borisnimcevic/flicker_stitch/fs_led_res_0805/fs_led_res_0805.kicad_pcb

## KiCad design fs_led_res_0805/fs_led_res_0805.kicad_pcb (2026-09-19)

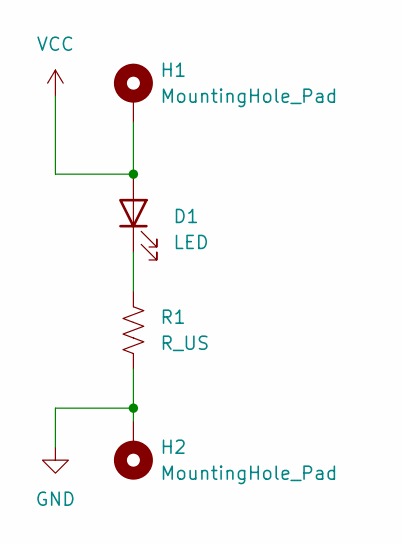
[picture p1: schematic fs_led_res_0805.kicad_sch, 0805 LED + resistor stitch breakout board]

Parts:
D1: LED; LED_0805_2012Metric_Pad1.15x1.40mm_HandSolder
H1, H2: MountingHole_Pad; MountingHole_2.2mm_M2_DIN965_Pad_TopBottom
R1: R_US; R_0805_2012Metric_Pad1.20x1.40mm_HandSolder

Connections:
GND: H2.1 (1_1), R1.2
unnamed: D1.1 (K), R1.1
VCC: D1.2 (A), H1.1 (1_1)

Board: 2 copper layers, 4 parts (1 on the bottom side), 3 nets, no tracks yet.
