borisnimcevic/flicker_stitch/fs_SAO/fs_SAO.kicad_pcb

## KiCad design fs_SAO/fs_SAO.kicad_pcb (2026-04-27)

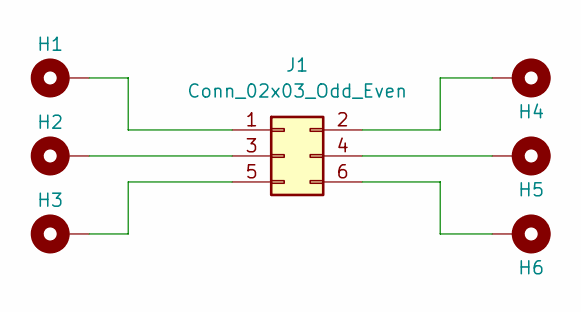
[picture p4: schematic fs_SAO.kicad_sch, 2x3 connector breakout]

Parts:
H1, H2, H3, H4, H5, H6: MountingHole_Pad; MountingHole_2.2mm_M2_Pad_TopBottom
J1: Conn_02x03_Odd_Even; IDC-Header_2x03_P2.54mm_Vertical_SMD

Connections:
unnamed: H1.1 (1_1), J1.1
unnamed: H4.1 (1_1), J1.2
unnamed: H2.1 (1_1), J1.3
unnamed: H5.1 (1_1), J1.4
unnamed: H3.1 (1_1), J1.5
unnamed: H6.1 (1_1), J1.6

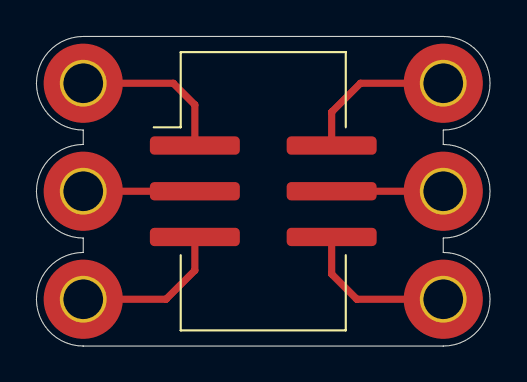
[picture p5: board fs_SAO.kicad_pcb from above]

Board: 2 copper layers, 25.2 x 17.2 mm, 7 parts (0 on the bottom side), 6 nets.
